kochluis598-a11y/ESP32-Synth/README.md

# ESP32-Synth
Ein digitaler Synth auf Basis des ESP32. Der ESP32 erzeugt digitale Audiosignale und gibt diese über einen externen Audioverstärker wieder. Die Tonhöhe wird über kapazitive Touch-Eingänge gesteuert, die aus gefrästen Kupferflächen bestehen.
