kochluis598-a11y/ESP32-Synth/3D models/ESP32 Synth (9).stl

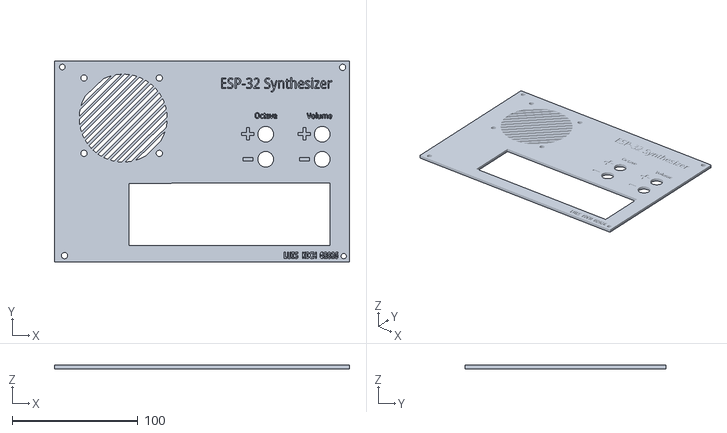
[picture p9: CAD file, 2026-04-29]
3D models/ESP32 Synth (9).stl
235.0 x 160.0 x 3.00
