kochluis598-a11y/ESP32-Synth/3D models/ESP32 Synth v2.0 (und halter).stl

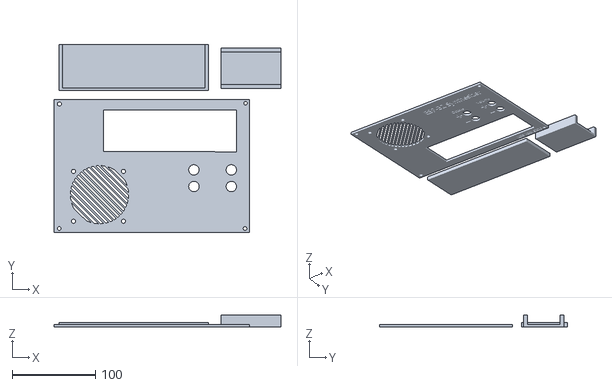
[picture p10: CAD file, 2026-04-29]
3D models/ESP32 Synth v2.0 (und halter).stl
273.0 x 226.0 x 14.0
